Open-Source-Alternator-Regulator/alt-CAD/README.md

# CAD
Hardware design files for Alternator Regulator
