Open-Source-Alternator-Regulator/alt-CAD/CAD-files/AltReg-CAN.kicad_pcb

## KiCad design CAD-files/AltReg-CAN.kicad_pcb (2019-01-20)

Schematic: AltReg-CAN.sch, CAN enabled DCAlternator Regulator using Arduino IDE

Parts:
C1: 4.7nF; SM0603_Capa; Part # 710-885012207070
C2, C5, C9, C10, C12, C13, C16, C17, C19, C20, C22, C25, C26, C27, C28: 100nF; SM0805; Part # 80-C0805C104K5R
C4, C11, C29: 150pF; SM0805; Part # 581-08055C151K
C6, C7: 47pF; SM0603_Capa; Part # 77-VJ0603A470JXACBC
C14: 0.47uF; SM0805; Part # Optional: 603-CC805KKX7R8BB474
C15, C18, C24: 4.7uF; SM1206; Part # 81-GRM31CR71E475KA88
C21, C23, C30: 0.47uF; SM0805; Part # 603-CC805KKX7R8BB474
C31: 47uF/100v; CP_10x16mm; Part # 647-UPW2A470MPD
C32: 56uF; CP_6.3x11mm; Part # 647-UHD1V560MED
D1: SMAJ64A; do214ac; Part # 24V Option: 511-SMAJ30A-TR
D2, D18: SMAJ64A; do214ac; Part # 625-SMAJ64A-E3
D3, D4: CG0603MLC-05E; SM0603; Part # 652-CG0603MLC-05E
D5: SMAJ30A; do214ac; Part # 511-SMAJ30A-TR
D6, D9, D13, D15, D16: ESD5Z5.0T1G; sod523; Mouser 863-ESD5Z5.0T1G
D7, D11: BAT54S; SOT23; Part # 863-BAT54SLT1G
D8, D19: FSV20100V; TO277-DIODE; Part # 512-FSV20100V
D12, D14, D17: S110; sod123HE; Part # 512-S110FP
D20: SSA210; DO-214AC(SMA); Part # 625-VSSA210-E3/61T
D21: NUP2105L; SOT23; Part # 863-NUP2105LT1G
D22: LED; LED-5MM-DUAL; Mouser 604-WP59EGW
H1, H2, H3, H4: HOLE; hole_3mm
J1: VBat-Shunt; Solder_trace
J2: I2C; PIN_ARRAY_2X1
J3: USB_MICRO; conn_usb_B_micro_vertical_TH
J4: USB_MICRO; conn_usb_B_micro_vertical
J5, J7: RJ45; RJ45_8; Part # 538-42410-8504 or 649-54602-908LF
J6: TERM; PIN_ARRAY_2X1
J8, J9, J10: GND-Opt; Solder_trace
K1: B; JST-B2B-XH-A; Part # JST XH2.54 2P
K2: A; JST-B2B-XH-A; Part # JST XH2.54 2P
L1: 10uH; SM0805; Part # 810-MLZ2012N100L
L2: 680uH; INDUCTOR_LRS; Part # 580-12LRS684C or 580-12LRS105C
P1: USB; PIN_ARRAY_5x1
P2: CONN_4; mkds_1,5-4; Part # 651-1935187
P3: CONN_5; mkds_1,5-5
P4: ICSP; pin_array_3x2; Part # 649-67996-206HLF
P5: CAN; PCB_Terminal_3.81mm_3pin; Part # 158-P02EK381V3-E
P6: CONN_6; mkds_1,5-6; Part # 651-1935815
Q1: NZT605; sot223
Q2: T3904; SOT23; Part # 863-MMBT3904LT1G
Q3, Q4: TPW4R50ANH; DSOP-8; Part# 757-TPW4R50ANHL1Q
R1: 30K 0.1%; SM0805; Part # 603-RT0805BRD0730KL
R2, R9, R26, R29: 10; SM0603_Resistor; Part # 71-CRCW0603-10-E3
R3, R10: 0; SM0603_Resistor; Part # Optional: 660-RK73Z1JTTD
R4, R7, R31: 37.8K; SM0603_Resistor; Mouser 667-ERJ-3EKF3742V
R5: 20K 0.1%; SM0805; Part # 603-RT0805BRD0720KL
R6, R23, R43: 1M; SM0603_Resistor; Part # 667-ERJ-3EKF1004V
R8, R19, R22, R40, R42: 1K; SM0603_Resistor; Part # 667-ERJ-3EKF1001V
R11: 221; SM0603_Resistor; Part # 279-CPF0603B221RE1
R12, R13: 27; SM0603_Resistor; Part # 667-ERJ-3EKF27R0V
R14, R15: 4.99K; SM0603_Resistor; Part # 284-APC0603B4K99N
R16: 0; SM0603_Resistor; Part # 660-RK73Z1JTTD
R17, R20, R21, R24, R35, R36, R37, R38: 10K; SM0603_Resistor; Part # 667-ERJ-3EKF1002V
R18: 1K; SM0603_Resistor; Part # Optional: 667-ERJ-3EKF1001V
R27, R30, R32, R33, R34, R41: 100; SM0603_Resistor; Part # 667-ERJ-3EKF1000V
R28: 120; SM1210; Mouser 603-RC1210FR-07120RL
R39: 100K; SM0603_Resistor; Part # 667-ERJ-3EKF1003V
S1: SW_DIP-8; SWDIP8u; Part # 774-2108MS or 642-DPL08(right angle)
TH1: 10K NTC; SM0402; Part # 81-NCP15XH103F03RC
TP1: Vdd; PINTST
U2: INA282; SO8E; Part # 595-INA282AIDR
U3: INA226; MSOP10-0.5; Part 3 595-INA226AIDGSR
U4: FT230X-S; ssop-16; Mouser Part# 895-FT230XS-R
U5: NCV1124; so-8; Mouser 863-NCV1124DR2G
U6: ATMEGA64M1-Ax; TQFP32; Part # 556-ATMEGA64M1-15AZ
U7: MIC4604; SO8E; Mouser 998-MIC4604YM-TR
U8: MCP2562; SO8E
U9: MC78M05CDT; DPAK2; Part # 511-L78M05CDT-TR
U10: MAX5033D; SO8E; Mouser Part# 700-MAX5033DASA
V1, V2, V3, V4, V5, V6, V7, V8, V9, V10, V11, V12, V13, V14, V15, V16, V17, V18, V19, V20: VIA; 02mm_via
X1: 16Mhz; resonator_smd

Connections:
+5V: C9.1, C16.2, C20.2, C22.1, C24.2, C26.1, C28.2, D7.2, D11.2, D12.2 (K), L1.2, P4.2, R14.1, R20.1, R21.1, R24.1, R35.1, R36.1, R37.1, R38.1, U2.3 (Ref_2), U2.7 (Ref1), U3.6 (Vss), U5.8 (Vcc), U6.4 (VCC), U8.3 (Vdd), U8.5 (Vio), U9.3 (OUT)
/3.3v: C10.2, R17.1, U4.3 (VCCIO), U4.10 (3V3OUT), U4.11 (~RESET)
/A_NTC: R32.2, U6.13 ((PCINT21/ADC2/ACMP2)PD5)
/B: D8.1 (A), P6.3, Q3.2 (D), Q4.2 (D)
/B_NTC: R34.2, U6.14 ((PCINT22/ADC3/INT0/ACMPN2)PD6)
/C: C18.1, D19.2 (K), P6.4, Q3.3 (S), Q4.3 (S), U7.4 (HS)
/CAN-H: D21.1, J5.1, J6.2 (PM), J7.1, P5.1, U8.7 (CANH)
/CAN-L: D21.2, J5.2, J7.2, P5.3, R28.2, U8.6 (CANL)
/CAN_GND: J5.3, J5.7, J7.3, J7.7
/CAN_shield: C14.1, J5.6, J7.6, P5.2 (PM)
/DIP-1: S1.1, U6.26 ((PCINT5/ADC6/INT2/ACMPN1/AMP2-)PB5)
/DIP-2: S1.2, U6.28 ((PCINT7/ADC4/SCK/PSCOUT0B)PB7)
/DIP-3: S1.3, U6.29 ((PCINT16/PSCOUT0A)PD0)
/DIP-4: S1.4, U6.18 ((PCINT13/ADC9/ACMP3/AMP1+)PC5)
/DIP-5: S1.5, U6.17 ((PCINT12/ADC8/ACMPN3/AMP1-)PC4)
/DIP-6: S1.6, U6.22 ((PCINT14/ADC10/ACMP1)PC6)
/DIP-7: S1.7, U6.16 ((PCINT2/ADC5/INT1/ACMPN0)PB2)
/DIP-8: S1.8, U6.15 ((PCINT23/ACMP0)PD7)
/FET_NTC: R24.2, TH1.2, U6.27 ((PCINT6/ADC7/PSCOUT1B)PB6)
/Feature_IN: R27.2, U6.24 ((PCINT4/AMP0+)PB4)
/Feature_OUT: R8.1, U6.23 ((PCINT3/AMP0-)PB3)
/Field PWM: U6.3 ((PCINT9/PSCIN1/OC1B/~SS_A~)PC1), U7.5 (HI)
/HO: R26.2, R29.2, U7.3 (HO)
/HO-Q1: Q4.1 (G), R26.1
/HO-Q3: Q3.1 (G), R29.1
/Hb: C18.2, D17.2 (K), U7.2 (Hb)
/LED_Green: D13.2 (K), P4.1, R42.1, U6.1 ((PCINT18/PSCIN2/OC1A/MISO_A)PD2)
/LED_Red: R40.1, U6.32 ((PCINT17/CLKO/PSCIN0)PD1)
/POL-PROT: C31.1, D14.2 (K), U10.5 (On/~Off), U10.7 (Vin)
/SCL: J2.2 (PM), R37.2, U3.5 (SCL), U6.9 ((PCINT1/MOSI/PSCOUT2B)PB1)
/SDA: J2.1, R35.2, U3.4 (SDA), U6.8 ((PCINT0/MISO/PSCOUT2A)PB0)
/Stator_IRQ: U5.7 (OUT1), U6.30 ((PCINT8/INT3/PSCOUT1A)PC0), U7.6 (LI)
/USB-SHLD: C1.2, J3.6, J4.6, P1.5, R6.2
/XD: C15.2, D12.1 (A), J3.1, J4.1, P1.1, U4.12 (VCC)
/XH: C27.2, C29.2, D20.2 (K), L2.1, U10.8 (LX)
/~RESET: C13.2, D7.3, P4.5, R20.2, U6.31 ((PCINT24/OCD/~RESET~)PE0)
Alt+: D8.2 (K), P6.1, P6.2
Alt-: D19.1 (A), J8.2, J9.2, J10.2, P6.5, P6.6
BAT-: C1.1, C4.1, C5.2, C6.1, C7.1, C9.2, C10.1, C11.2, C12.2, C15.1, C16.1, C17.1, C19.1, C20.1, C21.2, C22.2, C23.2, C24.1, C25.2, C26.2, C28.1, C30.2, C31.2, C32.2, D1.1 (A), D2.1 (A), D3.1 (A), D4.1 (A), D5.1 (A), D6.1 (A), D7.1, D9.1 (A), D11.1, D13.1 (A), D15.1 (A), D16.1 (A), D18.1 (A), D20.1 (A), D21.3, D22.K, J3.5, J4.5, J8.1, J9.1, J10.1, P1.4, P2.1, P4.6, Q1.3, R5.1, R6.1, R16.1, R18.2, R23.1, R30.2, R31.1, R33.2, R39.1, R41.2, S1.9, S1.10, S1.11, S1.12, S1.13, S1.14, S1.15, S1.16, TH1.1, U2.2 (GND), U3.1 (A1), U3.2 (A0), U3.7 (GND), U4.5 (GND), U4.6 (~CTS), U4.13 (GND), U5.4 (GND), U5.5 (DIAG), U6.5 (GND), U6.20 (AGND), U7.7 (Vss), U8.2 (Vss), U8.8 (STBY), U9.2 (GND), U10.3 (SGND), U10.6 (GND), V1.1, V2.1, V3.1, V4.1, V5.1, V6.1, V7.1, V8.1, V9.1, V10.1, V11.1, V12.1, V13.1, V14.1, V15.1, V16.1, V17.1, V18.1, V19.1, V20.1, X1.2
Current Shunt +: D2.2 (K), J1.1, P2.3, R2.1
Current Shunt -: D1.2 (K), P2.4, R9.1
Enable: D14.1 (A), D18.2 (K), P3.5
Feature-IN: P3.3, R4.1
Feature-OUT: P3.4, Q1.2
unnamed: K2.1, R30.1
unnamed: K1.1, R33.1
unnamed: D22.A1, R40.2
unnamed: D22.A2, R42.2
unnamed: R15.1, U2.5 (Out)
unnamed: C2.2, R2.2, R3.1, U2.8 (In+)
unnamed: C2.1, R9.2, R10.1, U2.1 (In-)
unnamed: R31.2, U5.1 (Radj)
unnamed: C11.1, R7.2, U5.2 (IN1)
unnamed: J5.8, J7.8
unnamed: U6.7 ((PCINT11/T1/ICP1B/RXCAN)PC3), U8.4 (RXD)
unnamed: U6.6 ((PCINT10/T0/TXCAN)PC2), U8.1 (TXD)
unnamed: C23.1, D15.2 (K), K2.2 (PM), R32.1, R36.2
unnamed: C12.1, D11.3, R4.2, R23.2, R27.1
unnamed: C4.2, D5.2 (K), R1.2, R5.2, U3.8 (Vbus)
unnamed: J5.4, J7.4
unnamed: C25.1, U10.2 (VD)
unnamed: C27.1, U10.1 (BST)
unnamed: J5.5, J7.5
unnamed: C29.1, R41.1
unnamed: R16.2, U6.25 ((PCINT15/D2A/AMP2+)PC7)
unnamed: R39.2, R43.1, U10.4 (FB)
unnamed: C17.2, U6.21 (AREF(ISRC))
unnamed: U6.11 ((PCINT26/ADC0/XTAL2)PE2), X1.1
unnamed: C21.1, D16.2 (K), K1.2 (PM), R34.1, R38.2
unnamed: J3.4, J4.4
unnamed: C7.2, D4.2 (K), J3.3, J4.3, P1.3, R13.1
unnamed: Q1.1, R8.2
unnamed: R19.2, U7.8 (LO)
unnamed: R10.2, R11.1, R14.2, U3.9 (Vin-)
unnamed: R3.2, R11.2, R15.2, U3.10 (Vin+)
unnamed: C14.2, R18.1
unnamed: J6.1, R28.1
unnamed: U6.10 ((PCINT25/OC0B/XTAL1)PE1), X1.3
unnamed: C6.2, D3.2 (K), J3.2, J4.2, P1.2, R12.1
unnamed: Q2.1 (B), R17.2
unnamed: R12.2, U4.9 (USBDM)
unnamed: R13.2, U4.8 (USBDP)
unnamed: Q2.2 (E), U4.2 (~RTS)
unnamed: R22.2, U4.1 (TXD)
unnamed: D9.2 (K), P4.3, R22.1, U6.12 ((PCINT20/ADC1/RXD/RXLIN/ICP1A/SCK_A)PD4)
unnamed: D6.2 (K), P4.4, U4.4 (RXD), U6.2 ((PCINT19/TXD/TXLIN/OC0A/~SS~/MOSI_A)PD3)
unnamed: C13.1, Q2.3 (C), R21.2
unnamed: C19.2, L1.1, U6.19 (AVCC)
STATOR: P3.1, R7.1
Tach-OUT: P3.2, R19.1
VBat+: J1.2, P2.2, R1.1
VDD: C5.1, C30.1, C32.1, D17.1 (A), L2.2, R43.2, TP1.1, U2.6 (V+), U7.1 (Vdd), U9.1 (IN)

Notes on the sheet:
D12 allows configuration of unit via USB on bench
Dip 1..2 = CAN battery ID Dip 3..5 = Charge profile / Battery type Dip 6..7 = Bat Capacity Dip 8 = Small Alt Mode
P8 may be used to optionaly connect directly to wires, or a bulkhead connector (e.g. NMEA-2000). Ref CANopen spec CiA-303
A-Temp
Vdd = 13.4v
High Drive: A-jumper-B, C -field- D Low Drive: A -field- B, C-jumper-D
Design Point: 65v max Battery / System Voltage (32v max with '24v' stuffing option)
Q1/Q3 temp sensor
Stuffing Option - on-board USB
B-Temp
Note: When using RJ-45 connectors, utilize "DMX Termination Plug" on end nodes
Option: Solder Jumpers to allow low wire count install See Users Manual.
Note: D20 & C32 are critical components. Take care with part # subs. See MAX5033D datasheet for details
Note: Configure uC to use external Vcc (5v) ADC Vref
Shield Gnd Populate R18, C14 only if needed
A-Temp: Alternator B-Temp: Battery, or optionaly 2nd alterantor (See users guide)
CAUTION: If J1 & J8..J10 are bridged on PCB, install a 2-position connector for P2. Leaving the BAT- and VBat+ pins unaccessable.
24v - stuffing option: Install R3, R10, R16 Do not populate R11, R14, R15, R5, C5, U2 Change C4 to .1uF, change R1 to 10-ohms Change D1, D2 to SMJ30A (511-SMAJ30A-TR) Sysem max becomes 30V (battery target 24v max) R16 is used to signal to software this otion is installed.

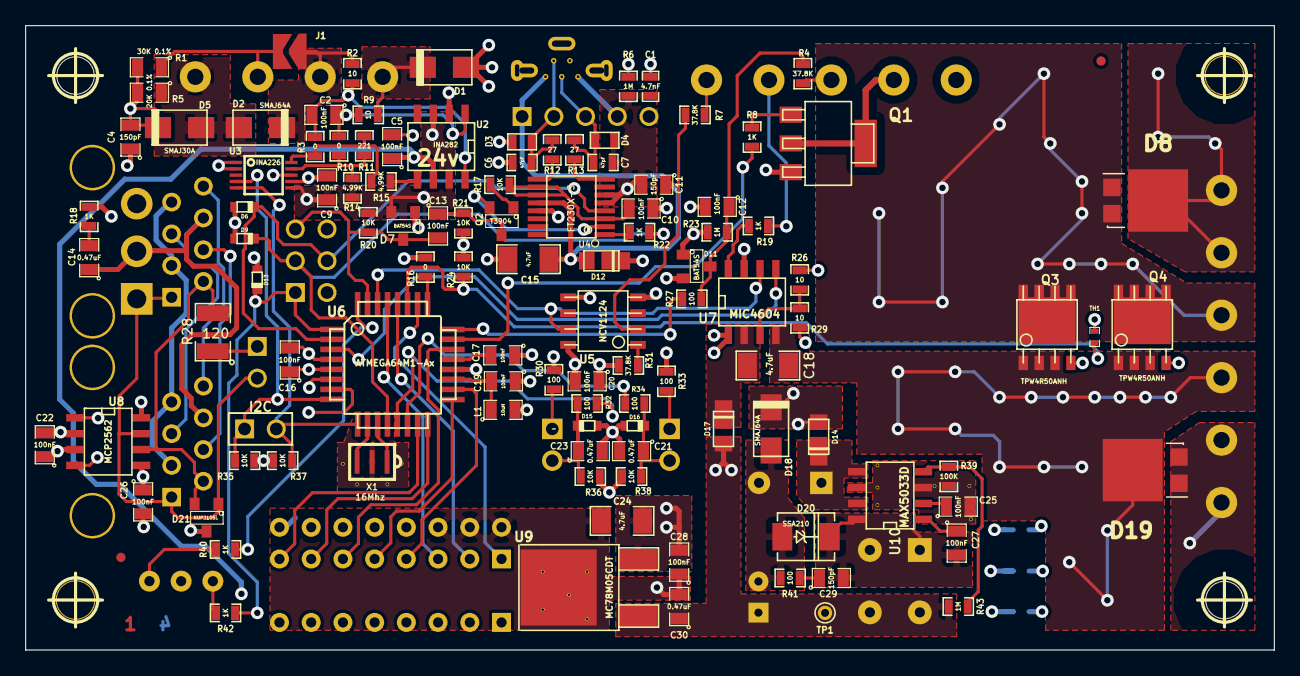
[picture p1: board AltReg-CAN.kicad_pcb from above]

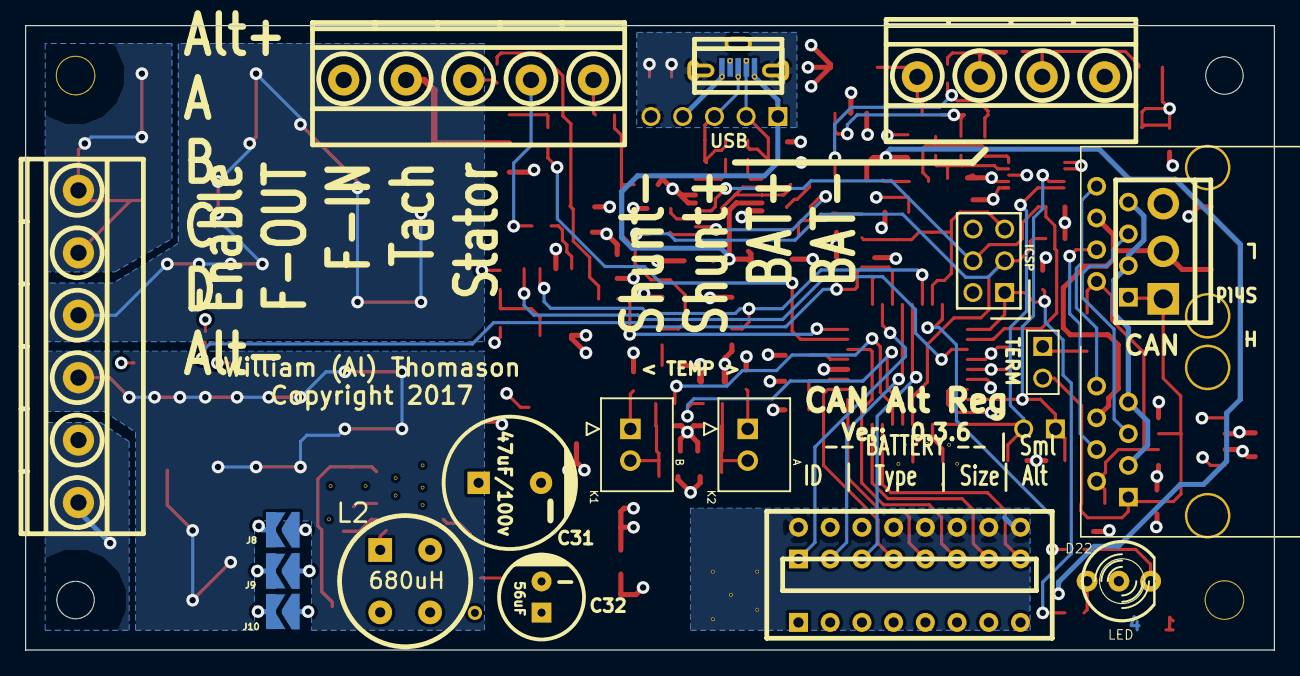
[picture p2: board AltReg-CAN.kicad_pcb from below]

Board: 4 copper layers, 100.0 x 50.0 mm, 156 parts (21 on the bottom side), 92 nets.

Other parts of the board:
fiducial_075_300_round, fiducial_075_300_round#2: VAL**; fiducial_075_300_round
