Open-Source-Alternator-Regulator/alt-CAD/(notices)

Notices in the files:
CAD-files/AltReg-CAN.kicad_pcb:
Copyright 2016 - William A. Thomason
Licensed under a Creative Commons Attribution-ShareAlike 4.0 International License.
Copyright 2017
CAD-files/AltReg-CAN.sch:
Copyright 2017 - William A. Thomason
